astroeng/SuperDuino/superDuino BOM.xlsx

 | DigiKey PN | Cost @ Qty | Qty
1.5 Volt regulator | 576-1161-ND | 1.19 | 1 | 1.19
3.3 Volt Regulator | 576-1172-ND | 1.4 | 1 | 1.4
5.0 Volt Regulator | 576-1173-ND | 1.4 | 1 | 1.4
Female DB 25 | AE10940-ND | 1.16 | 3 | 3.48
Male DB 25 | AE10985-ND | 1.16 | 3 | 3.48
FPGA | 1100-1030-ND | 18.26 | 1 | 18.26
PIC | PIC24FJ256GA110-I/PT-ND | 5.84 | 1 | 5.84
Header | WM50014-36-ND | 0.98 | 1 | 0.98
Radial Cap | P13476-ND | 0.32 | 3 | 0.96
0805 Cap | 399-1168-1-ND | 0.1 | 4 | 0.4
Parts |  |  |  | 37.39
PCB |  |  |  | 13
Total |  |  |  | 50.39
