astroeng/SuperDuino/superDuino1.brd

## EAGLE design superDuino1.brd (2016-02-08)

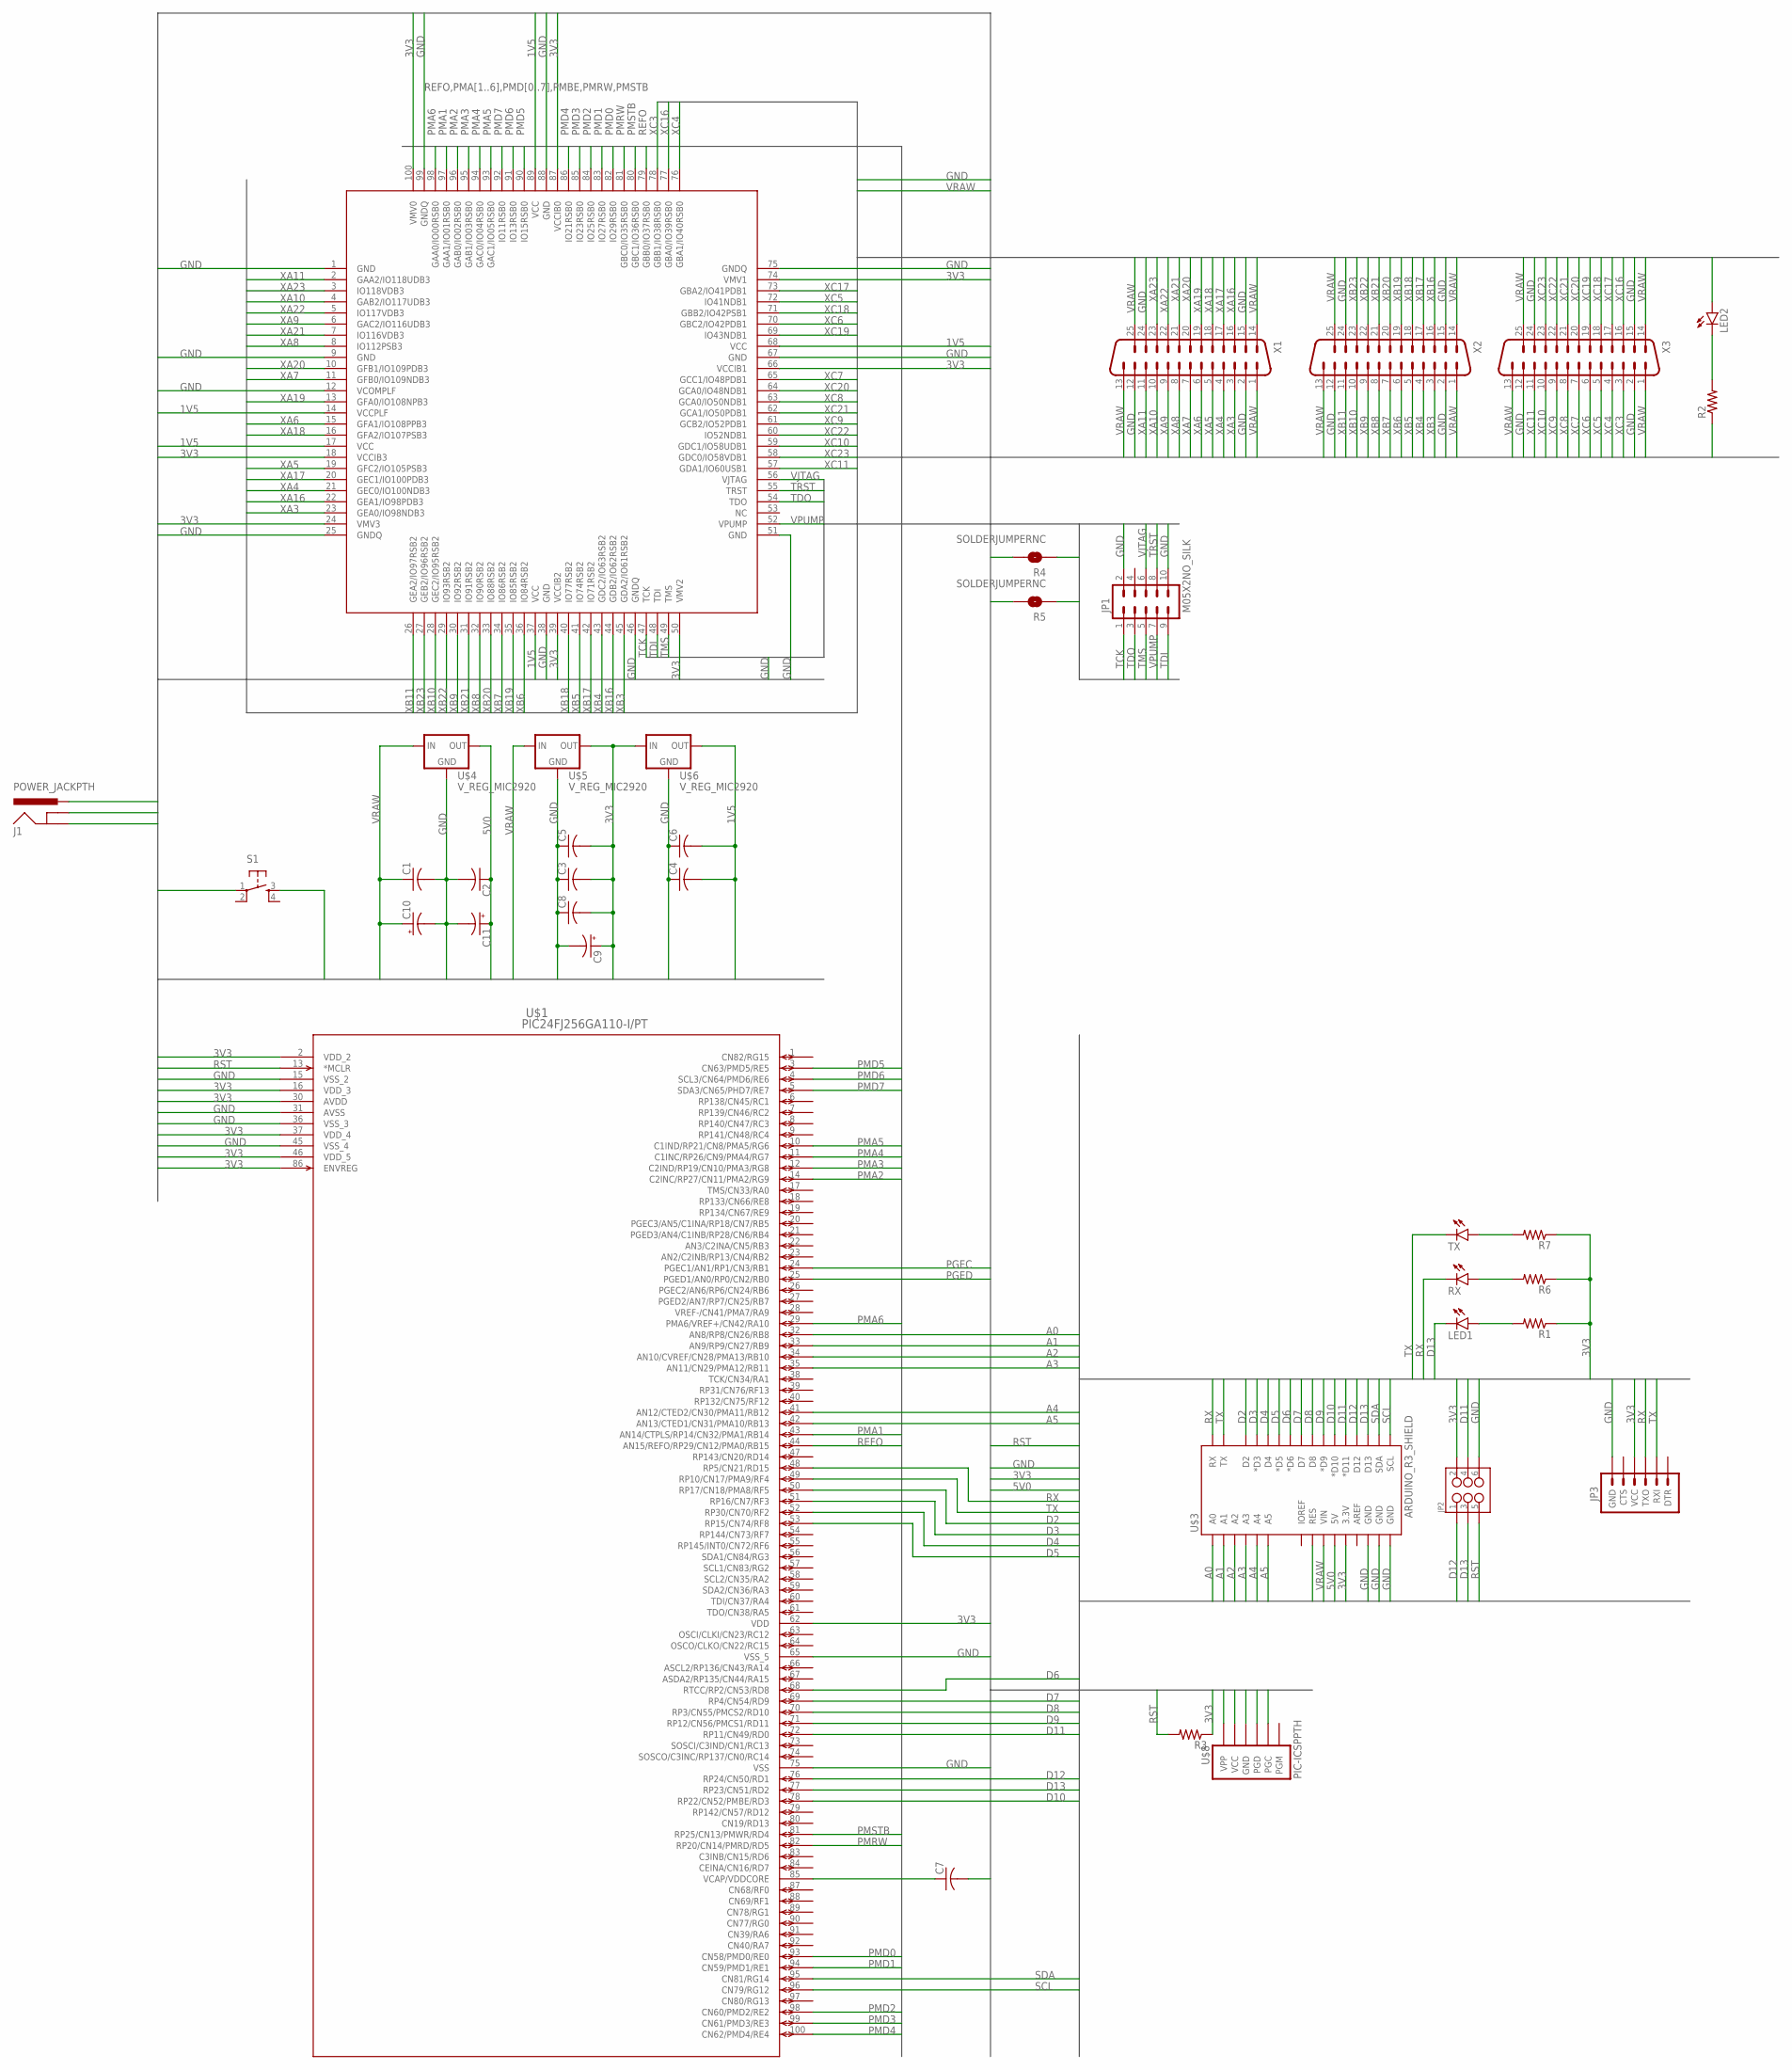
[picture p1: schematic superDuino1.sch]

Parts:
C1, C2, C3, C4, C5, C6, C8: C-USC0805; C0805
C7: C-US050-035X075; C050-035X075
C9, C10, C11: CPOL-USE2.5-6; E2,5-6
J1: POWER_JACKPTH; POWER_JACK_PTH
JP1: M05X2NO_SILK; 2X5_NOSILK
JP2: M03X22X3_SILK_SM; 2X3
JP3: ARDUINO_SERIAL_PROGRAMPTH; 1X06
LED1, LED2: LED1206; LED-1206
R1, R2, R3, R6, R7: R-US_R0805; R0805
R4, R5: SOLDERJUMPERNC; SJ_2S
RX: LED1206; LED-1206
S1: TAC_SWITCHPTH; TACTILE-PTH
TX: LED1206; LED-1206
U$1: PIC24FJ256GA110-I/PT; TQFP100_12X12MC
U$2: A3P250-VQ100; VQ100
U$3: ARDUINO_R3_SHIELD; UNO_R3_SHIELD
U$4, U$5, U$6: V_REG_MIC2920; SOT223
U$8: PIC-ICSPPTH; MOLEX-1X6
X1, X2, X3: DB25H; M25H

Connections:
1V5: C4.2, C6.2, U$2.14 (VCCPLF), U$2.17 (VCC), U$2.37 (VCC), U$2.68 (VCC), U$2.89 (VCC), U$6.3 (OUT)
3V3: C3.2, C5.2, C8.2, C9.+, JP2.2, JP3.VCC, R1.1, R3.1, R4.2, R5.2, R6.1, R7.1, U$1.2 (VDD_2), U$1.16 (VDD_3), U$1.30 (AVDD), U$1.37 (VDD_4), U$1.46 (VDD_5), U$1.62 (VDD), U$1.86 (ENVREG), U$2.18 (VCCIB3), U$2.24 (VMV3), U$2.39 (VCCIB2), U$2.50 (VMV2), U$2.66 (VCCIB1), U$2.74 (VMV1), U$2.87 (VCCIB0), U$2.100 (VMV0), U$3.3.3V, U$5.3 (OUT), U$6.1 (IN), U$8.5 (VCC)
5V0: C2.1, C11.+, U$3.5V, U$4.3 (OUT)
A0: U$1.32 (AN8/RP8/CN26/RB8), U$3.A0
A1: U$1.33 (AN9/RP9/CN27/RB9), U$3.A1
A2: U$1.34 (AN10/CVREF/CN28/PMA13/RB10), U$3.A2
A3: U$1.35 (AN11/CN29/PMA12/RB11), U$3.A3
A4: U$1.41 (AN12/CTED2/CN30/PMA11/RB12), U$3.A4
A5: U$1.42 (AN13/CTED1/CN31/PMA10/RB13), U$3.A5
D2: U$1.50 (RP17/CN18/PMA8/RF5), U$3.D2
D3: U$1.51 (RP16/CN7/RF3), U$3.D3 (*D3)
D4: U$1.52 (RP30/CN70/RF2), U$3.D4
D5: U$1.53 (RP15/CN74/RF8), U$3.D5 (*D5)
D6: U$1.68 (RTCC/RP2/CN53/RD8), U$3.D6 (*D6)
D7: U$1.69 (RP4/CN54/RD9), U$3.D7
D8: U$1.70 (RP3/CN55/PMCS2/RD10), U$3.D8
D9: U$1.71 (RP12/CN56/PMCS1/RD11), U$3.D9 (*D9)
D10: U$1.78 (RP22/CN52/PMBE/RD3), U$3.D10 (*D10)
D11: JP2.4, U$1.72 (RP11/CN49/RD0), U$3.D11 (*D11)
D12: JP2.1, U$1.76 (RP24/CN50/RD1), U$3.D12
D13: JP2.3, LED1.C, U$1.77 (RP23/CN51/RD2), U$3.D13
GND: C1.2, C2.2, C3.1, C4.1, C5.1, C6.1, C7.2, C8.1, C9.-, C10.-, C11.-, J1.GND, J1.GNDBREAK, JP1.2, JP1.10, JP2.6, JP3.GND, R2.1, S1.1, U$1.15 (VSS_2), U$1.31 (AVSS), U$1.36 (VSS_3), U$1.45 (VSS_4), U$1.65 (VSS_5), U$1.75 (VSS), U$2.1 (GND), U$2.9 (GND), U$2.12 (VCOMPLF), U$2.25 (GNDQ), U$2.38 (GND), U$2.46 (GNDQ), U$2.51 (GND), U$2.67 (GND), U$2.75 (GNDQ), U$2.88 (GND), U$2.99 (GNDQ), U$3.GND@0 (GND), U$3.GND@1 (GND), U$3.GND@2 (GND), U$4.2 (GND), U$5.2 (GND), U$6.2 (GND), U$8.4 (GND), X1.2, X1.12, X1.15, X1.24, X2.2, X2.12, X2.15, X2.24, X3.2, X3.12, X3.15, X3.24
unnamed: LED1.A, R1.2
unnamed: C7.1, U$1.85 (VCAP/VDDCORE)
unnamed: LED2.C, R2.2
unnamed: R7.2, TX.A
unnamed: R6.2, RX.A
PGEC: U$1.24 (PGEC1/AN1/RP1/CN3/RB1), U$8.2 (PGC)
PGED: U$1.25 (PGED1/AN0/RP0/CN2/RB0), U$8.3 (PGD)
PMA1: U$1.43 (AN14/CTPLS/RP14/CN32/PMA1/RB14), U$2.97 (GAA1/IO01RSB0)
PMA2: U$1.14 (C2INC/RP27/CN11/PMA2/RG9), U$2.96 (GAB0/IO02RSB0)
PMA3: U$1.12 (C2IND/RP19/CN10/PMA3/RG8), U$2.95 (GAB1/IO03RSB0)
PMA4: U$1.11 (C1INC/RP26/CN9/PMA4/RG7), U$2.94 (GAC0/IO04RSB0)
PMA5: U$1.10 (C1IND/RP21/CN8/PMA5/RG6), U$2.93 (GAC1/IO05RSB0)
PMA6: U$1.29 (PMA6/VREF+/CN42/RA10), U$2.98 (GAA0/IO00RSB0)
PMD0: U$1.93 (CN58/PMD0/RE0), U$2.82 (IO29RSB0)
PMD1: U$1.94 (CN59/PMD1/RE1), U$2.83 (IO27RSB0)
PMD2: U$1.98 (CN60/PMD2/RE2), U$2.84 (IO25RSB0)
PMD3: U$1.99 (CN61/PMD3/RE3), U$2.85 (IO23RSB0)
PMD4: U$1.100 (CN62/PMD4/RE4), U$2.86 (IO21RSB0)
PMD5: U$1.3 (CN63/PMD5/RE5), U$2.90 (IO15RSB0)
PMD6: U$1.4 (SCL3/CN64/PMD6/RE6), U$2.91 (IO13RSB0)
PMD7: U$1.5 (SDA3/CN65/PHD7/RE7), U$2.92 (IO11RSB0)
PMRW: U$1.82 (RP20/CN14/PMRD/RD5), U$2.81 (GBC0/IO35RSB0)
PMSTB: U$1.81 (RP25/CN13/PMWR/RD4), U$2.80 (GBC1/IO36RSB0)
REFO: U$1.44 (AN15/REFO/RP29/CN12/PMA0/RB15), U$2.79 (GBB0/IO37RSB0)
RST: JP2.5, R3.2, S1.3, U$1.13 (*MCLR), U$3.RES, U$8.6 (VPP)
RX: JP3.TXO, RX.C, U$1.48 (RP5/CN21/RD15), U$3.RX
SCL: U$1.96 (CN79/RG12), U$3.SCL
SDA: U$1.95 (CN81/RG14), U$3.SDA
TCK: JP1.1, U$2.47 (TCK)
TDI: JP1.9, U$2.48 (TDI)
TDO: JP1.3, U$2.54 (TDO)
TMS: JP1.5, U$2.49 (TMS)
TRST: JP1.8, U$2.55 (TRST)
TX: JP3.RXI, TX.C, U$1.49 (RP10/CN17/PMA9/RF4), U$3.TX
VJTAG: JP1.6, R5.1, U$2.56 (VJTAG)
VPUMP: JP1.7, R4.1, U$2.52 (VPUMP)
VRAW: C1.1, C10.+, J1.PWR, U$3.VIN, U$4.1 (IN), U$5.1 (IN), X1.1, X1.13, X1.14, X1.25, X2.1, X2.13, X2.14, X2.25, X3.1, X3.13, X3.14, X3.25
XA3: U$2.23 (GEA0/IO98NDB3), X1.3
XA4: U$2.21 (GEC0/IO100NDB3), X1.4
XA5: U$2.19 (GFC2/IO105PSB3), X1.5
XA6: U$2.15 (GFA1/IO108PPB3), X1.6
XA7: U$2.11 (GFB0/IO109NDB3), X1.7
XA8: U$2.8 (IO112PSB3), X1.8
XA9: U$2.6 (GAC2/IO116UDB3), X1.9
XA10: U$2.4 (GAB2/IO117UDB3), X1.10
XA11: U$2.2 (GAA2/IO118UDB3), X1.11
XA16: U$2.22 (GEA1/IO98PDB3), X1.16
XA17: U$2.20 (GEC1/IO100PDB3), X1.17
XA18: U$2.16 (GFA2/IO107PSB3), X1.18
XA19: U$2.13 (GFA0/IO108NPB3), X1.19
XA20: U$2.10 (GFB1/IO109PDB3), X1.20
XA21: U$2.7 (IO116VDB3), X1.21
XA22: U$2.5 (IO117VDB3), X1.22
XA23: U$2.3 (IO118VDB3), X1.23
XB3: U$2.45 (GDA2/IO61RSB2), X2.3
XB4: U$2.43 (GDC2/IO63RSB2), X2.4
XB5: U$2.41 (IO74RSB2), X2.5
XB6: U$2.36 (IO84RSB2), X2.6
XB7: U$2.34 (IO86RSB2), X2.7
XB8: U$2.32 (IO90RSB2), X2.8
XB9: U$2.30 (IO92RSB2), X2.9
XB10: U$2.28 (GEC2/IO95RSB2), X2.10
XB11: U$2.26 (GEA2/IO97RSB2), X2.11
XB16: U$2.44 (GDB2/IO62RSB2), X2.16
XB17: U$2.42 (IO71RSB2), X2.17
XB18: U$2.40 (IO77RSB2), X2.18
XB19: U$2.35 (IO85RSB2), X2.19
XB20: U$2.33 (IO88RSB2), X2.20
XB21: LED2.A, U$2.31 (IO91RSB2), X2.21
XB22: U$2.29 (IO93RSB2), X2.22
XB23: U$2.27 (GEB2/IO96RSB2), X2.23
XC3: U$2.78 (GBB1/IO38RSB0), X3.3
XC4: U$2.76 (GBA1/IO40RSB0), X3.4
XC5: U$2.72 (IO41NDB1), X3.5
XC6: U$2.70 (GBC2/IO42PDB1), X3.6
XC7: U$2.65 (GCC1/IO48PDB1), X3.7
XC8: U$2.63 (GCA0/IO50NDB1), X3.8
XC9: U$2.61 (GCB2/IO52PDB1), X3.9
XC10: U$2.59 (GDC1/IO58UDB1), X3.10
XC11: U$2.57 (GDA1/IO60USB1), X3.11
XC16: U$2.77 (GBA0/IO39RSB0), X3.16
XC17: U$2.73 (GBA2/IO41PDB1), X3.17
XC18: U$2.71 (GBB2/IO42PSB1), X3.18
XC19: U$2.69 (IO43NDB1), X3.19
XC20: U$2.64 (GCA0/IO48NDB1), X3.20
XC21: U$2.62 (GCA1/IO50PDB1), X3.21
XC22: U$2.60 (IO52NDB1), X3.22
XC23: U$2.58 (GDC0/IO58VDB1), X3.23

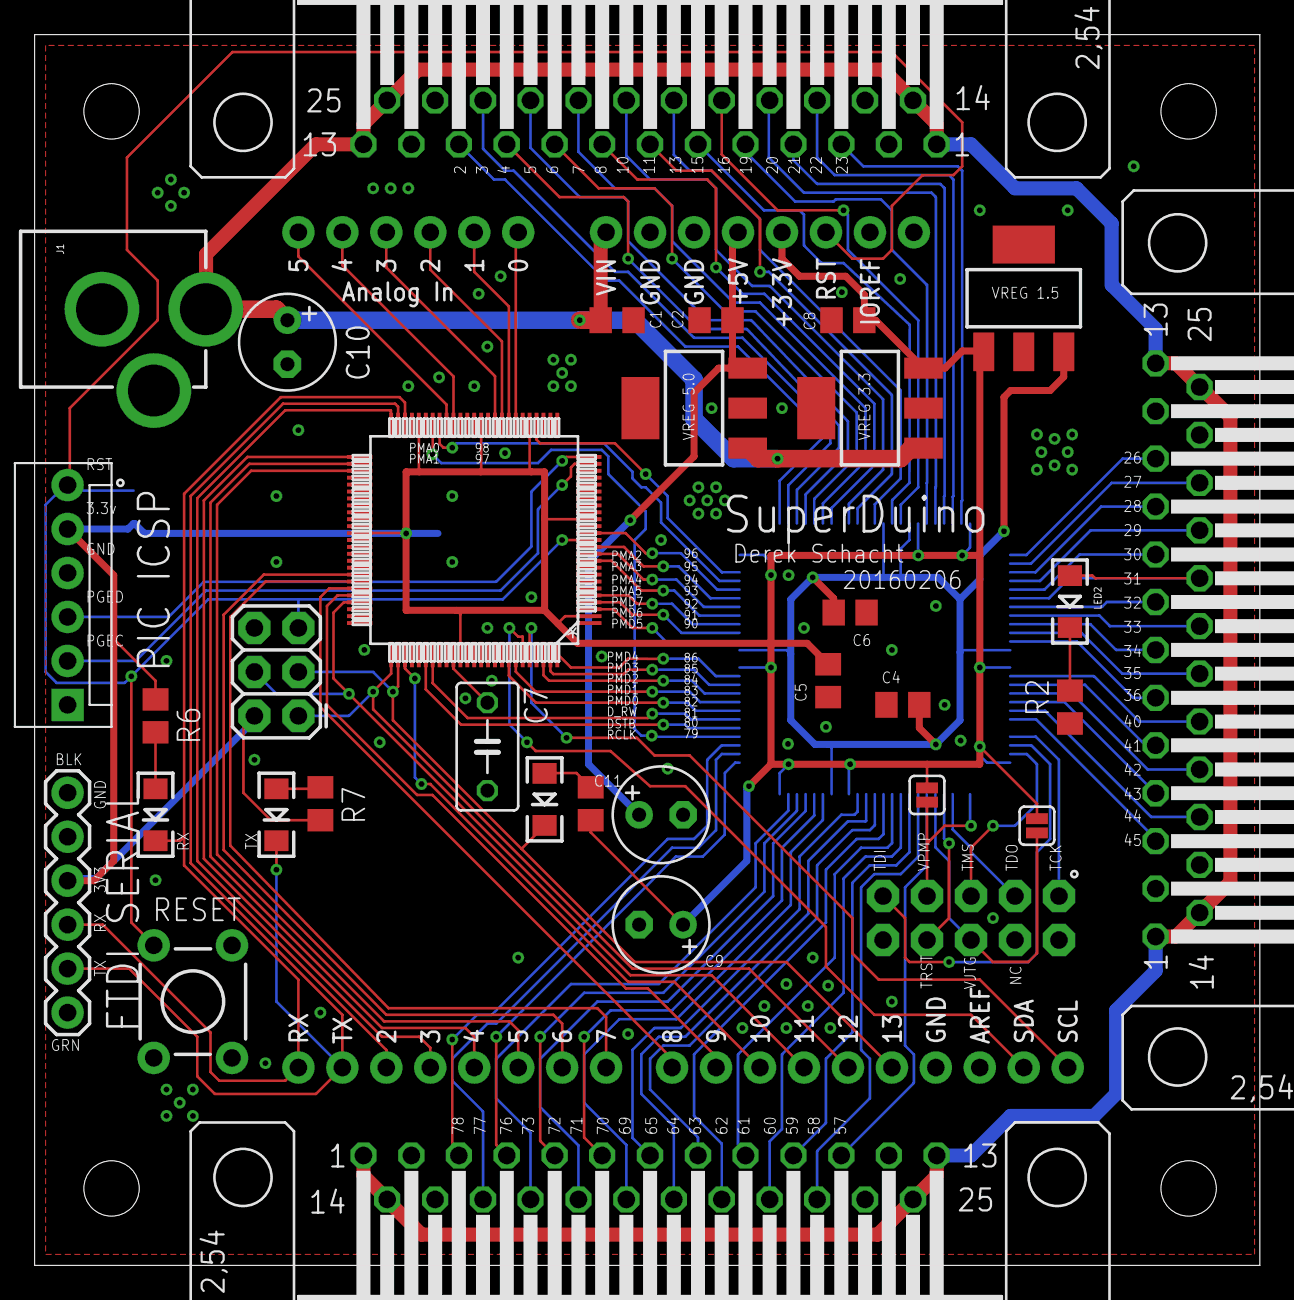
[picture p2: board superDuino1.brd from above]

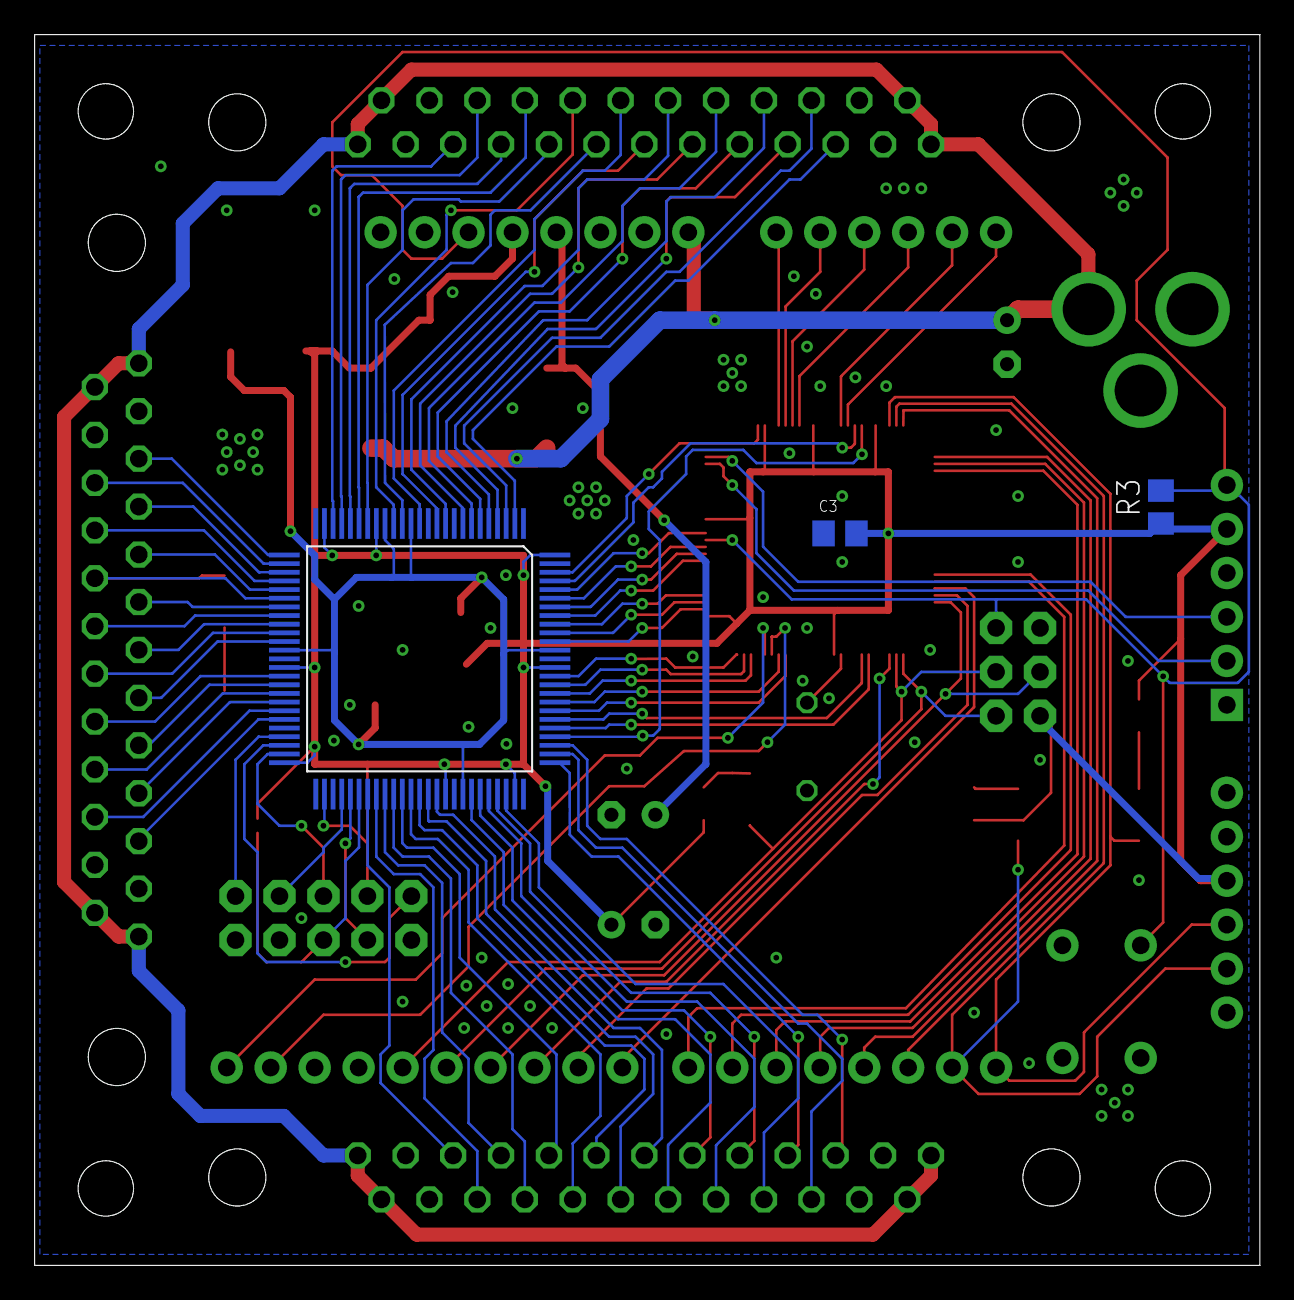
[picture p3: board superDuino1.brd from below]

Board: 2 copper layers, 70.8 x 71.1 mm, 37 parts (3 on the bottom side), 110 nets.
