astroeng/SuperDuino/(threads)

Thread 1 (2016-01-17):

Pullup Missing on Reset Line

astroeng, 2016-01-17:

astroeng, 2016-01-17:
Should probably add a reset button along with this change.

astroeng, 2016-02-07:
Added the pullup.

Closed 2016-02-08.

Thread 2 (2016-01-17):

FPGA component pads could be larger

astroeng, 2016-01-17:
If the pads for the FPGA were larger it would be far easier to solder the part on by hand.

astroeng, 2016-02-07:
Redid the FPGA package in Eagle... I had made this part from scratch since I could not find it in any library. First one so I think I did half decent since the part was actually the same size as the pads on the board.

Closed 2016-02-08.

Thread 3 (2016-01-17):

Programming header is inaccesable under certain conditions

astroeng, 2016-01-17:
PIC programming header requires the removal of the base board from any stacks to use.

astroeng, 2016-02-07:
Dropped the X4 DB25 and put a barrel style power jack, the PIC programming header, and and FTDI serial header on that edge.

Closed 2016-02-08.

Thread 4 (2016-01-17):

Power traces are too small

astroeng, 2016-01-17:
Use larger traces for power signals on next design.

astroeng, 2016-02-07:
Increased the size of the power traces to atleast 0.016. Also, the whole layout was redone.

Closed 2016-02-08.

Thread 7 (2016-02-03):

SPI bus implementation.

astroeng, 2016-02-03:
Need to implement the 6 pin Arduino ICSP header... since apparently some shields use those pins for the SPI interface.

astroeng, 2016-02-07:
Added the Arduino AVR ICSP header. This is not functional as an ICSP port but will now work for SPI needs.

Closed 2016-02-08.
