astroeng/SuperDuino/(commit log)

2016-01-17 SuperDuino initial commit.
    [superDuino BOM.xlsx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]
2016-02-08 Added a BOM file and updated schematic and layout to address: Issue #7, Issue #6, Issue #5, Issue #4, Issue #3, Issue #2, Issue #1
    [superDuino BOM.xlsx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]
